0Wulics0/ProyectoRobotica/Img/Boquilla.jpeg

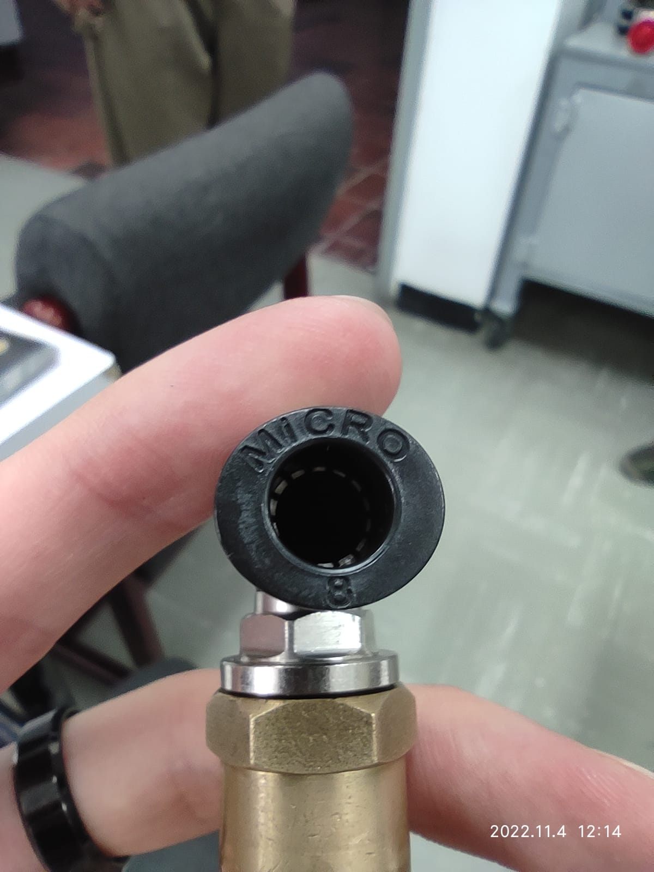
Img/Boquilla.jpeg
