0Wulics0/ProyectoRobotica/Img/EspacioDeTrabajo.PNG

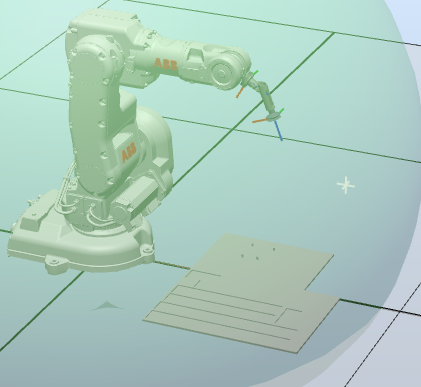
Img/EspacioDeTrabajo.PNG
