0Wulics0/ProyectoRobotica/Img/EstructuraRapid.PNG

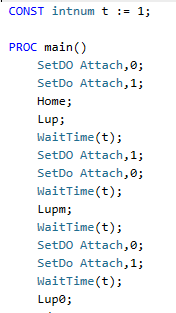
Img/EstructuraRapid.PNG
