0Wulics0/ProyectoRobotica/Img/Exhaust.jpeg

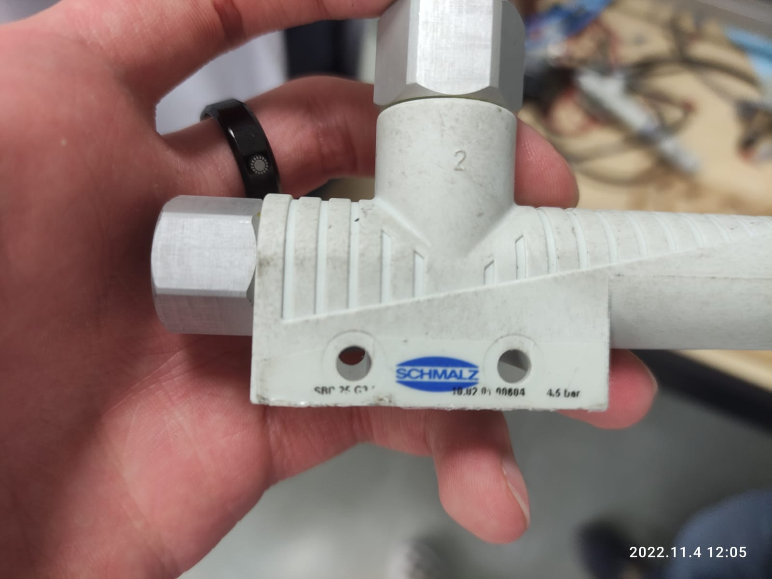
Img/Exhaust.jpeg
