0Wulics0/ProyectoRobotica/Img/InventorCompleto.jpeg

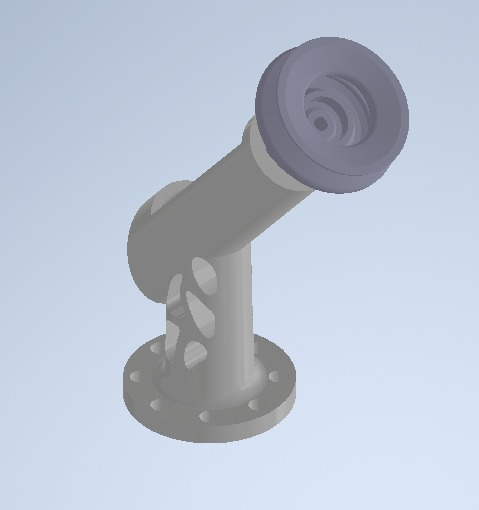
Img/InventorCompleto.jpeg
