0Wulics0/ProyectoRobotica/Img/Manguera1.jpeg

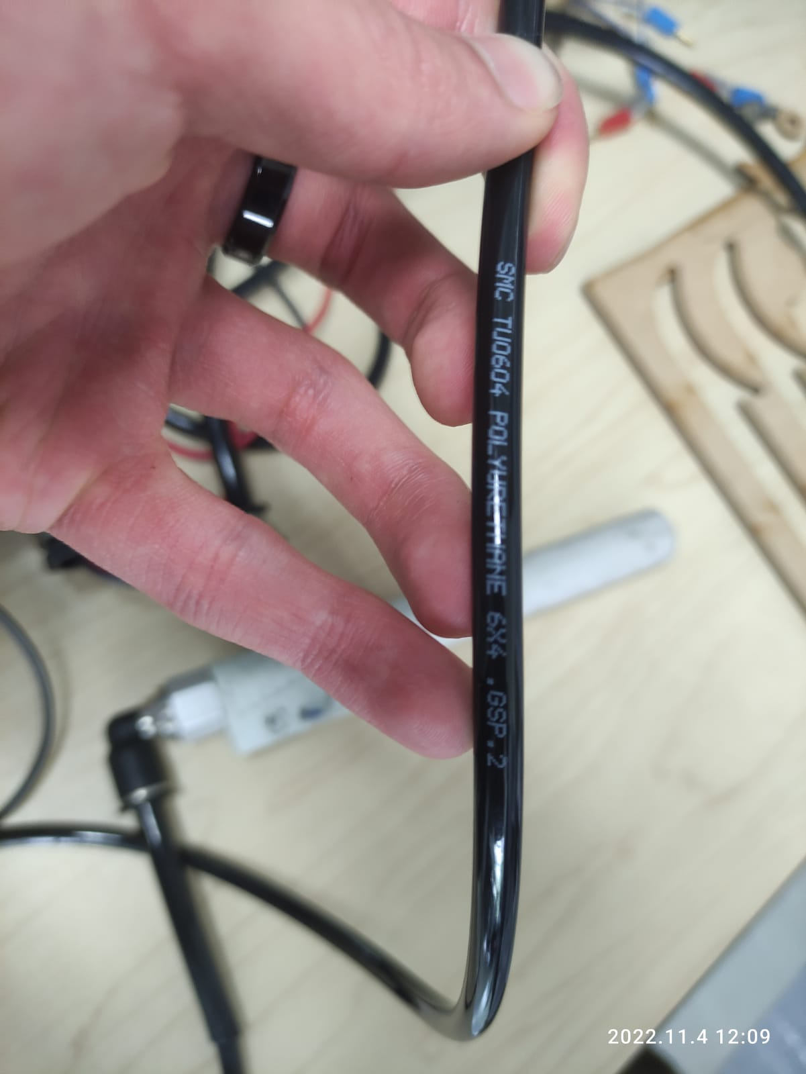
Img/Manguera1.jpeg
