0Wulics0/ProyectoRobotica/Img/Manguera2.jpeg

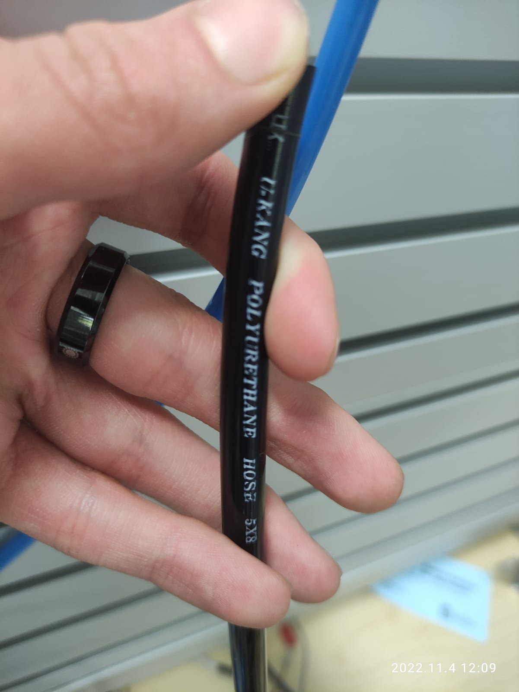
Img/Manguera2.jpeg
