0Wulics0/ProyectoRobotica/Img/Medidas.jpeg

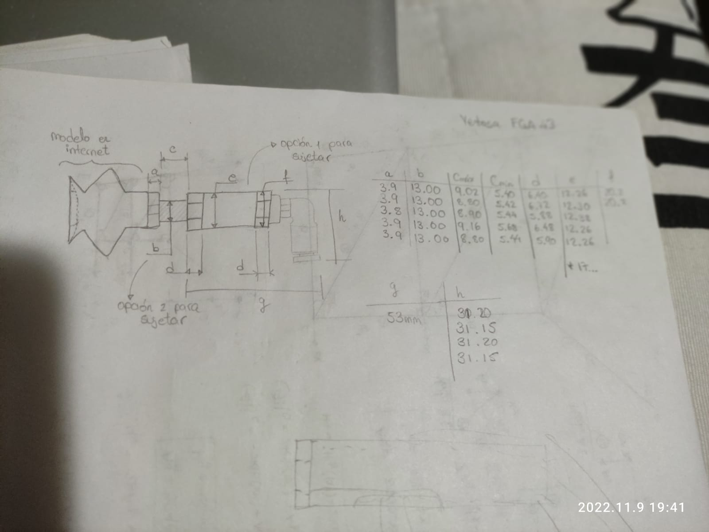
Img/Medidas.jpeg
