0Wulics0/ProyectoRobotica/Img/Piezas.jpeg

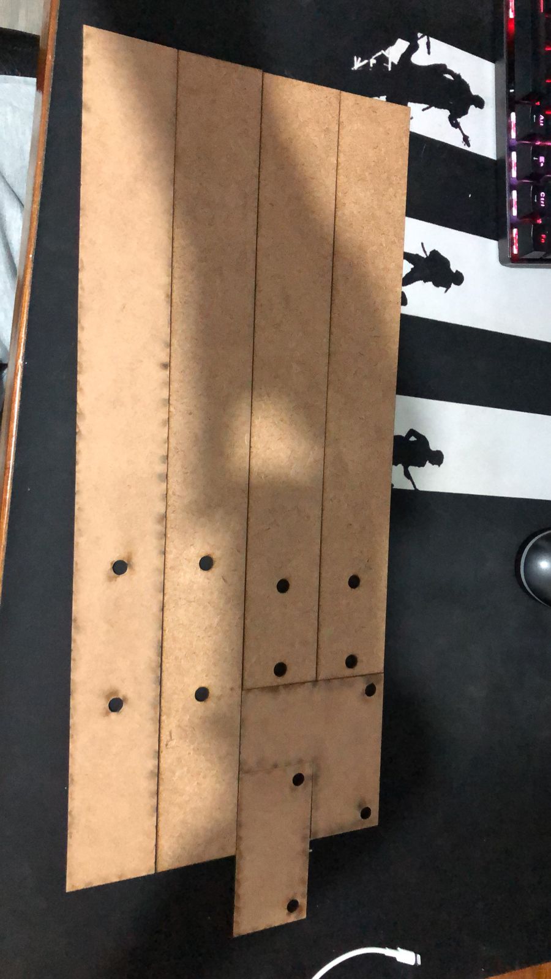
Img/Piezas.jpeg
