0Wulics0/ProyectoRobotica/Img/WOT1.JPG

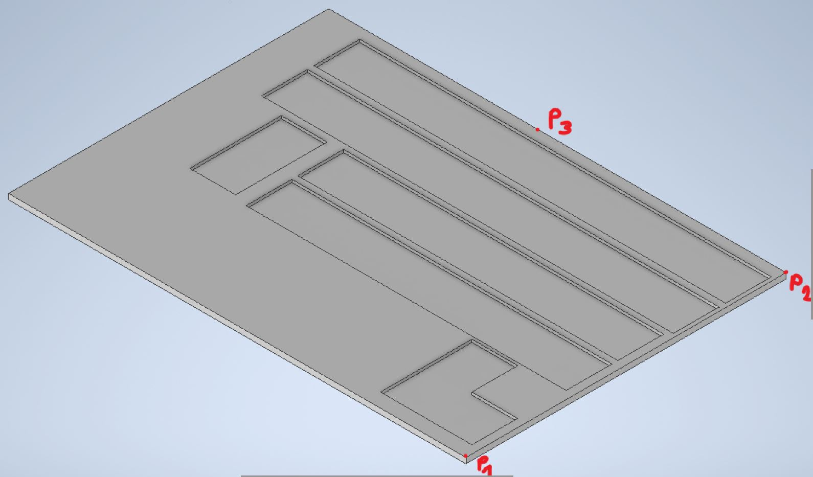
Img/WOT1.JPG
