0Wulics0/ProyectoRobotica/Img/WOT2.JPG

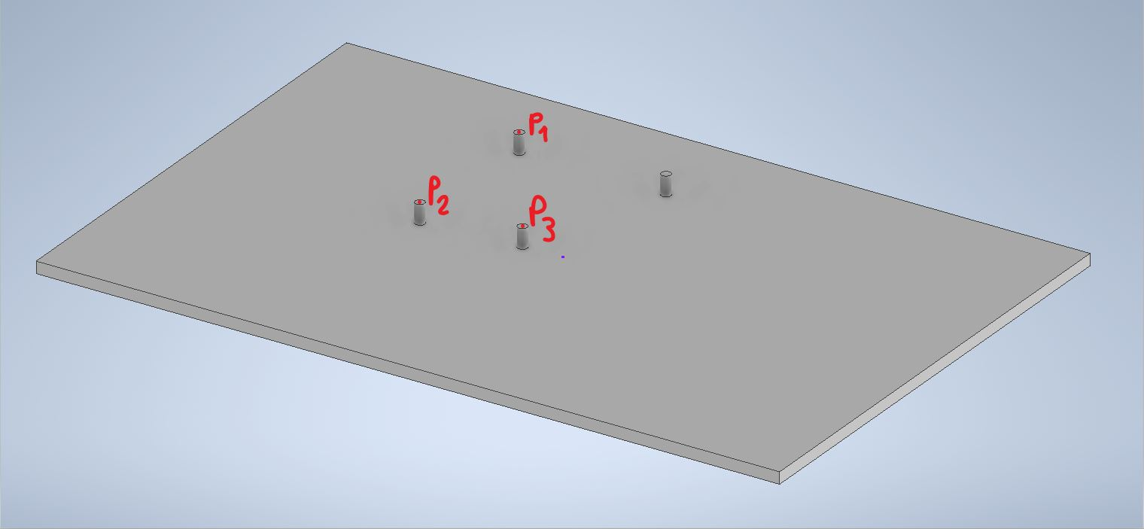
Img/WOT2.JPG
