0Wulics0/ProyectoRobotica/base de ensamble/Ensamblaje1.stp

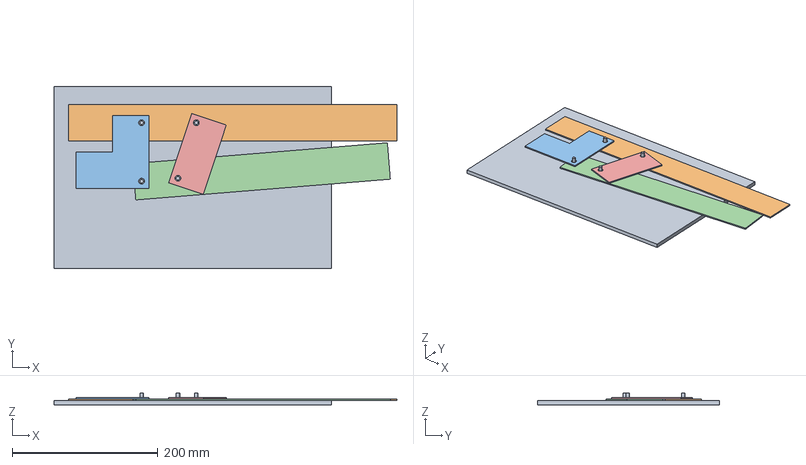
[picture p22: CAD file, 2022-11-23]
base de ensamble/Ensamblaje1.stp
470.0 x 250.0 x 16.0 mm
bensam
Lup
Pinz
Ldw
H
