0Wulics0/ProyectoRobotica/base inicial/binicial.stp

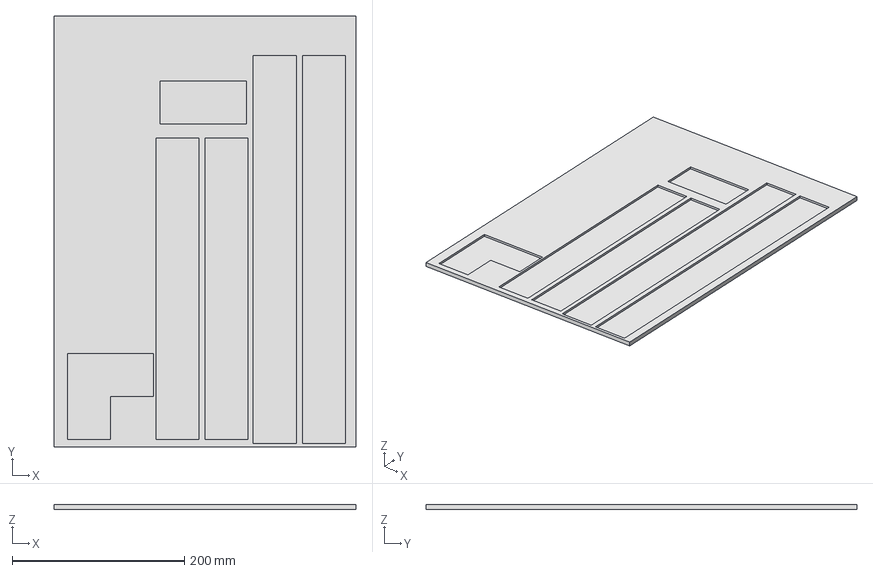
[picture p23: CAD file, 2022-11-23]
base inicial/binicial.stp
350.0 x 500.0 x 6.00 mm
