0Wulics0/ProyectoRobotica/base de ensamble/bensam.stp

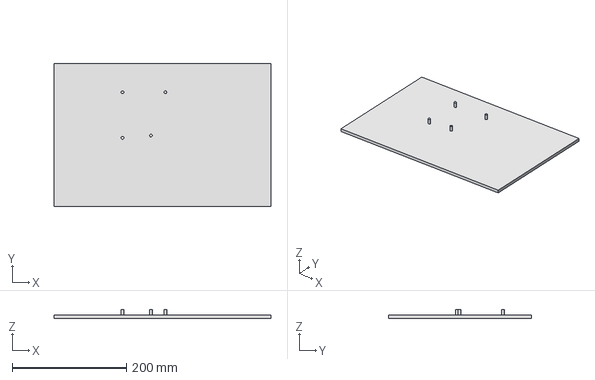
[picture p24: CAD file, 2022-11-23]
base de ensamble/bensam.stp
380.0 x 250.0 x 16.0 mm
