0Wulics0/ProyectoRobotica/(list of files, cad)

Other CAD files:
ModeloGripperFinal/plano.dwg
ModeloGripperFinal/OldVersions/plano.0004.dwg
Herramienta/10_01_06_00874.ipt
Herramienta/10_01_06_01065.ipt
Herramienta/10_01_06_01066.ipt
Herramienta/base.ipt
Herramienta/mventosa+t.iam
ModeloGripperFinal/Assembly1.iam
ModeloGripperFinal/Axis.ipt
ModeloGripperFinal/H.ipt
ModeloGripperFinal/Ldw.ipt
ModeloGripperFinal/Lup.ipt
ModeloGripperFinal/OldVersions/Assembly1.0004.iam
ModeloGripperFinal/OldVersions/Assembly1.0006.iam
ModeloGripperFinal/OldVersions/Axis.0001.ipt
ModeloGripperFinal/OldVersions/H.0001.ipt
ModeloGripperFinal/OldVersions/H.0002.ipt
ModeloGripperFinal/OldVersions/Ldw.0002.ipt
ModeloGripperFinal/OldVersions/Ldw.0005.ipt
ModeloGripperFinal/OldVersions/Lup.0002.ipt
ModeloGripperFinal/OldVersions/Lup.0005.ipt
ModeloGripperFinal/OldVersions/Pinz.0001.ipt
ModeloGripperFinal/OldVersions/Pinz.0002.ipt
ModeloGripperFinal/Pinz.ipt
base inicial/binicial.ipt
