0Wulics0/ProyectoRobotica/ModeloGripperFinal/plano.pdf

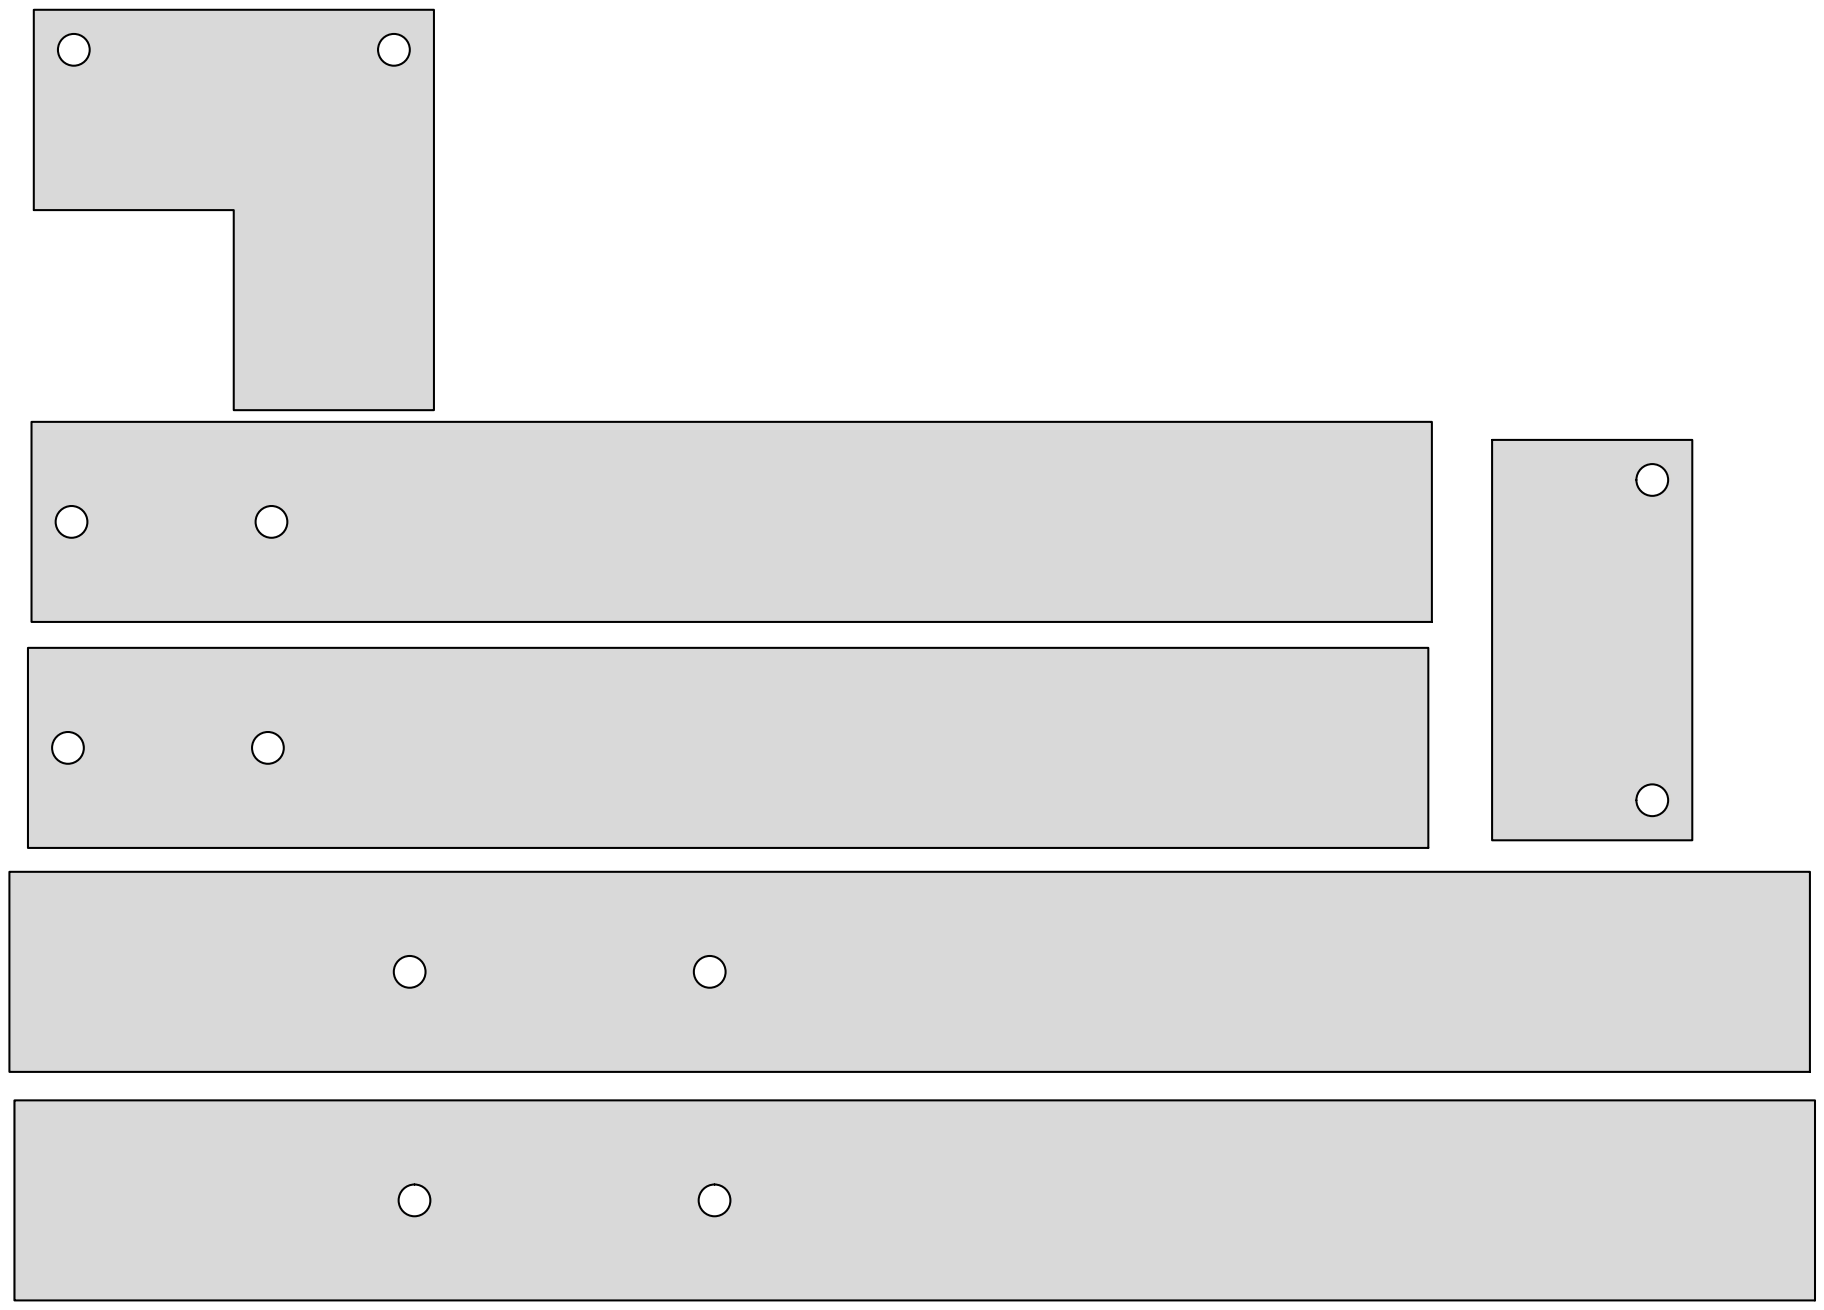
[picture p25: page 1]
