0Wulics0/ProyectoRobotica/todo funcionando 2.txt

MODULE Module1
    CONST robtarget Target_20:=[[229.12374666,96.731764507,97.263749646],[0.0045   ,-0.7009    ,0.7132   ,-0.0105],[-1,0,-2,0],[9E+09,9E+09,9E+09,9E+09,9E+09,9E+09]];
    CONST robtarget Target_20_2:=[[228.782590129,94.479925502,-2.710311156],[0.005884839,0.38264087,-0.923826969,0.00975011],[-1,0,-2,0],[9E+09,9E+09,9E+09,9E+09,9E+09,9E+09]];
    CONST robtarget Target_10:=[[286.192182184,358.139537963,556.107701921],[0.171957146,-0.001936356,0.985040077,-0.011092229],[0,0,0,0],[9E+09,9E+09,9E+09,9E+09,9E+09,9E+09]];
    CONST robtarget Target_30:=[[245.510885963,551.88763337,89.95657104],[0.005884839,0.38264087,-0.923826969,0.00975011],[0,1,-2,0],[9E+09,9E+09,9E+09,9E+09,9E+09,9E+09]];
    CONST robtarget Target_30_2:=[[245.169729432,549.635794365,-10.017489763],[0.005884839,0.38264087,-0.923826969,0.00975011],[0,1,-2,0],[9E+09,9E+09,9E+09,9E+09,9E+09,9E+09]];
    CONST robtarget Target_40_2:=[[184.040008961,152.340124362,96.165060034],[0.005884839,0.38264087,-0.923826969,0.00975011],[-1,1,-2,0],[9E+09,9E+09,9E+09,9E+09,9E+09,9E+09]];
    CONST robtarget Target_40:=[[183.69885248,150.088285465,-3.809000771],[0.005884839,0.38264087,-0.923826969,0.00975011],[-1,1,-2,0],[9E+09,9E+09,9E+09,9E+09,9E+09,9E+09]];
    CONST robtarget Target_50_2:=[[285.049655836,483.705888558,91.357388428],[0.007029214,0.492374909,-0.870308711,0.008960253],[0,0,-2,0],[9E+09,9E+09,9E+09,9E+09,9E+09,9E+09]];
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
    PROC Home()
        MoveL Target_10,v200,z30,succión\WObj:=Tabla;
    ENDPROC
    PROC Lupm()
        MoveL Target_20,v200,z30,succión\WObj:=Tabla;
        MoveL Target_30,v200,z30,succión\WObj:=Tabla;
        MoveL Target_30_2,v200,z30,succión\WObj:=Tabla;
    ENDPROC
    PROC Lup0()
        MoveL Target_30,v200,z30,succión\WObj:=Tabla;
    ENDPROC
    PROC Ldw()
        MoveL Target_40_2,v200,z30,succión\WObj:=Tabla;
        MoveL Target_40,v200,z30,succión\WObj:=Tabla;
    ENDPROC
    PROC Ldwm()
        MoveL Target_40_2,v200,z30,succión\WObj:=Tabla;
        MoveL Target_50_2,v200,z30,succión\WObj:=Tabla;
        MoveL Target_50,v200,z30,succión\WObj:=Tabla;
    ENDPROC
    PROC Ldw0()
        MoveL Target_50_2,v200,z30,succión\WObj:=Tabla;
    ENDPROC
    PROC H()
        MoveL Target_60_2,v200,z30,succión\WObj:=Tabla;
        MoveL Target_60,v200,z30,succión\WObj:=Tabla;
    
    ENDPROC
    PROC Hm()
        MoveL Target_60_2,v200,z30,succión\WObj:=Tabla;
        MoveL Target_60_3,v200,z30,succión\WObj:=Tabla;
        MoveL Target_60_4,v200,z30,succión\WObj:=Tabla;
        MoveL Target_60_5,v200,z30,succión\WObj:=Tabla;
        MoveL Target_60_6,v200,z30,succión\WObj:=Tabla;
        
    ENDPROC
    PROC H0()
        !MoveL Target_70_2,v200,z30,succión\WObj:=Tabla;
    ENDPROC
    PROC L()
        MoveL Target_20,v200,z30,succión\WObj:=Tabla;
        MoveL Target_20_1,v200,z30,succión\WObj:=Tabla;
        MoveL Target_80_2_1,v200,z30,succión\WObj:=Tabla;
        MoveL Target_80_2_3,v200,z30,succión\WObj:=Tabla;
        MoveL Target_80_2_4,v200,z30,succión\WObj:=Tabla;
        MoveL Target_80_2_3,v200,z30,succión\WObj:=Tabla; 
        !Bajar y
        MoveL Target_80_2_5,v200,z30,succión\WObj:=Tabla; 
        MoveL Target_80_2_6,v200,z30,succión\WObj:=Tabla; 
        MoveL Target_80_2_7,v200,z30,succión\WObj:=Tabla; 
        
    ENDPROC
    PROC Lm()
        MoveL Target_80_2,v200,z30,succión\WObj:=Tabla;
        MoveL Target_90_2,v200,z30,succión\WObj:=Tabla;
        MoveL Target_90,v200,z30,succión\WObj:=Tabla;
    ENDPROC
    PROC L0()
        MoveL Target_90_2,v200,z30,succión\WObj:=Tabla;
    ENDPROC
    PROC Lup3()
        MoveL Target_100_2,v200,z30,succión\WObj:=Tabla;
        MoveL Target_100,v200,z30,succión\WObj:=Tabla;
    ENDPROC
    PROC Lup3m()
        MoveL Target_100_2,v200,z30,succión\WObj:=Tabla;
        MoveL Target_110_2,v200,z30,succión\WObj:=Tabla;
        MoveL Target_110,v200,z30,succión\WObj:=Tabla;
        
    ENDPROC
    PROC Lup30()
        MoveL Target_110_2,v200,z30,succión\WObj:=Tabla;
        MoveL Target_110_1_1,v200,z30,succión\WObj:=Tabla;
        MoveL Target_110_1_2,v200,z30,succión\WObj:=Tabla;
        MoveL Target_110_1_3,v200,z30,succión\WObj:=Tabla;
        MoveL Target_110_1_4,v200,z30,succión\WObj:=Tabla;
        !MoveL Target_120_2,v200,z30,succión\WObj:=Tabla;
        !MoveL Target_120,v200,z30,succión\WObj:=Tabla;
    ENDPROC
    PROC Ldw3()
        
    ENDPROC
    PROC Ldw3m()
        MoveL Target_130_2,v200,z30,succión\WObj:=Tabla;
        MoveL Target_130,v200,z30,succión\WObj:=Tabla;
    ENDPROC
    PROC Ldw30()
        MoveL Target_130_2,v200,z30,succión\WObj:=Tabla;
    ENDPROC
ENDMODULE
