0Wulics0/ProyectoRobotica/(commit log)

2022-11-25 Fotos y videos gripper
2022-11-26 PlanoGripper
    Arreglada la resulución
2022-11-26 corrección de imágenes
